VaibhavAher100/stm32-vitals-monitor/results/both_sensors_combined_output.png

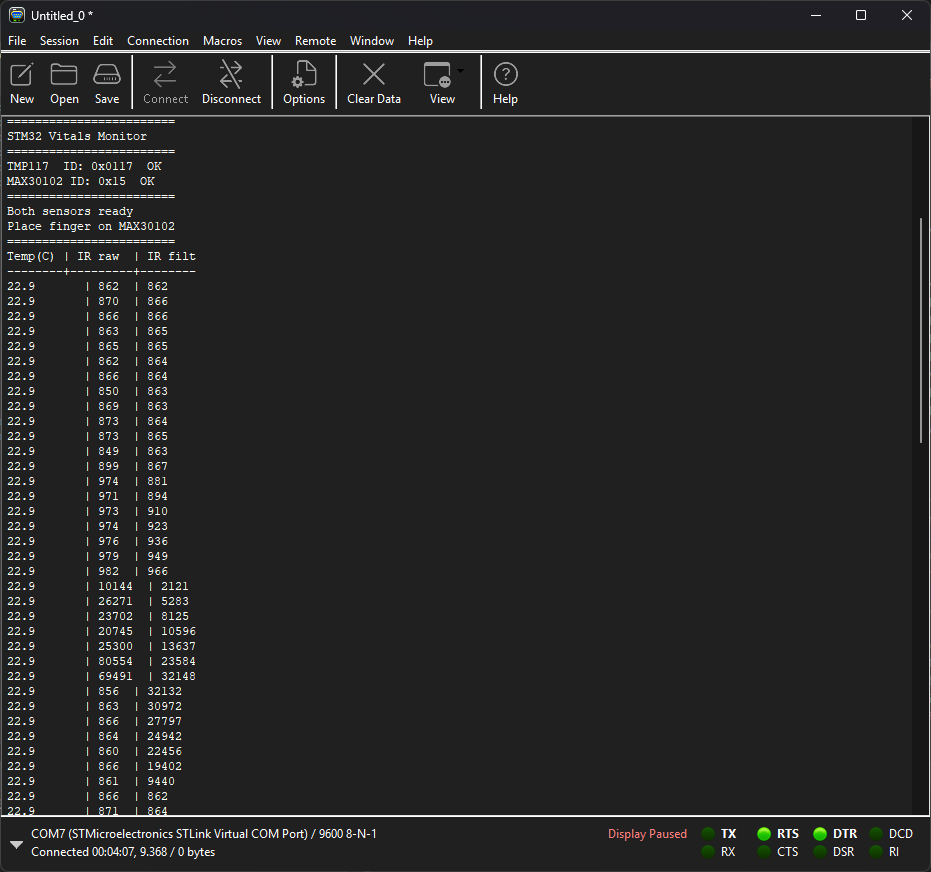
results/both_sensors_combined_output.png
