VaibhavAher100/stm32-vitals-monitor/results/freertos_bpm_output_verified.png

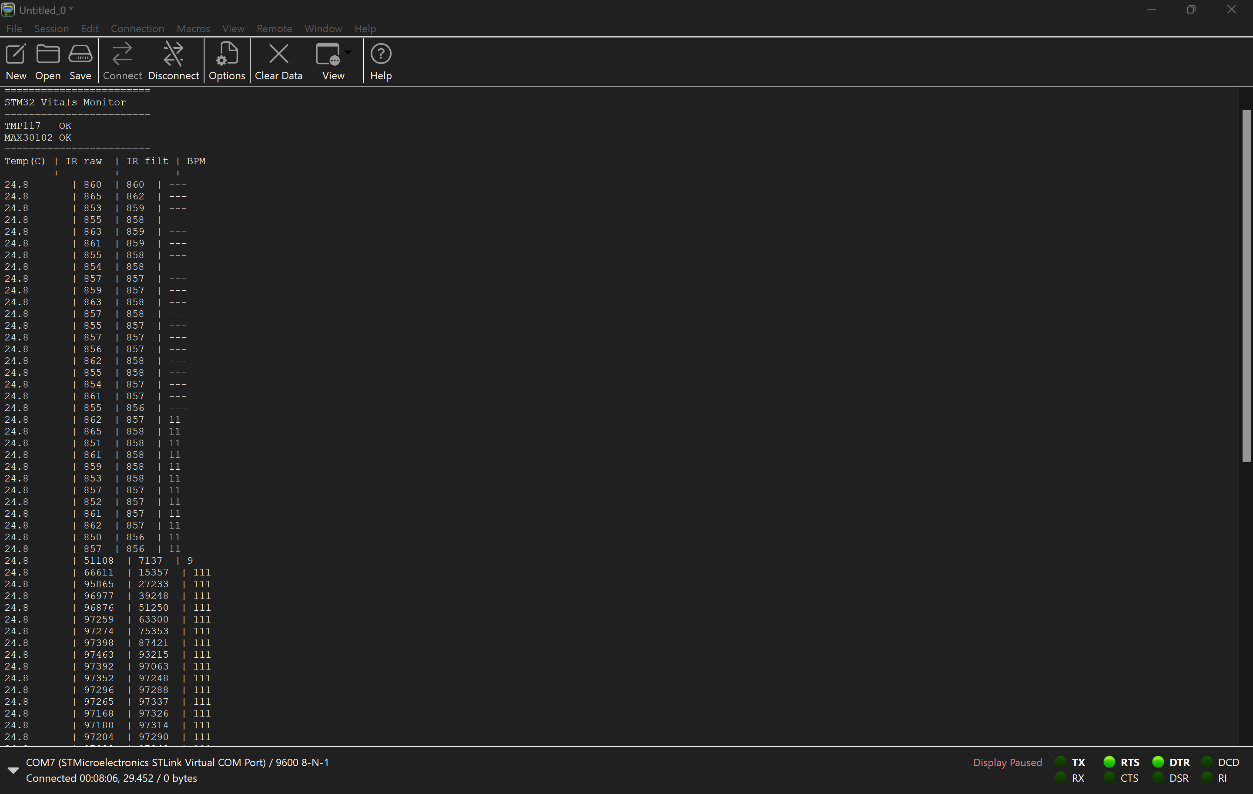
results/freertos_bpm_output_verified.png
