VaibhavAher100/stm32-vitals-monitor/results/i2c_scanner_both_sensors.png

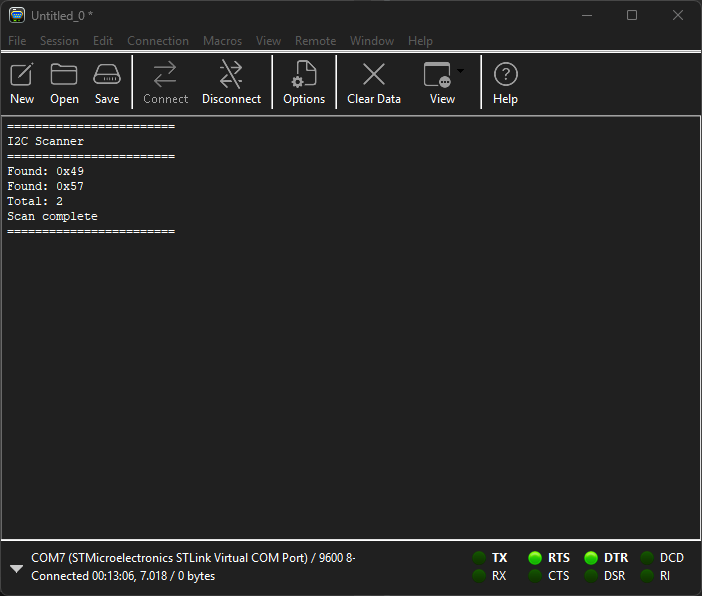
results/i2c_scanner_both_sensors.png
