VaibhavAher100/stm32-vitals-monitor/results/max30102_ir_raw_verified.png

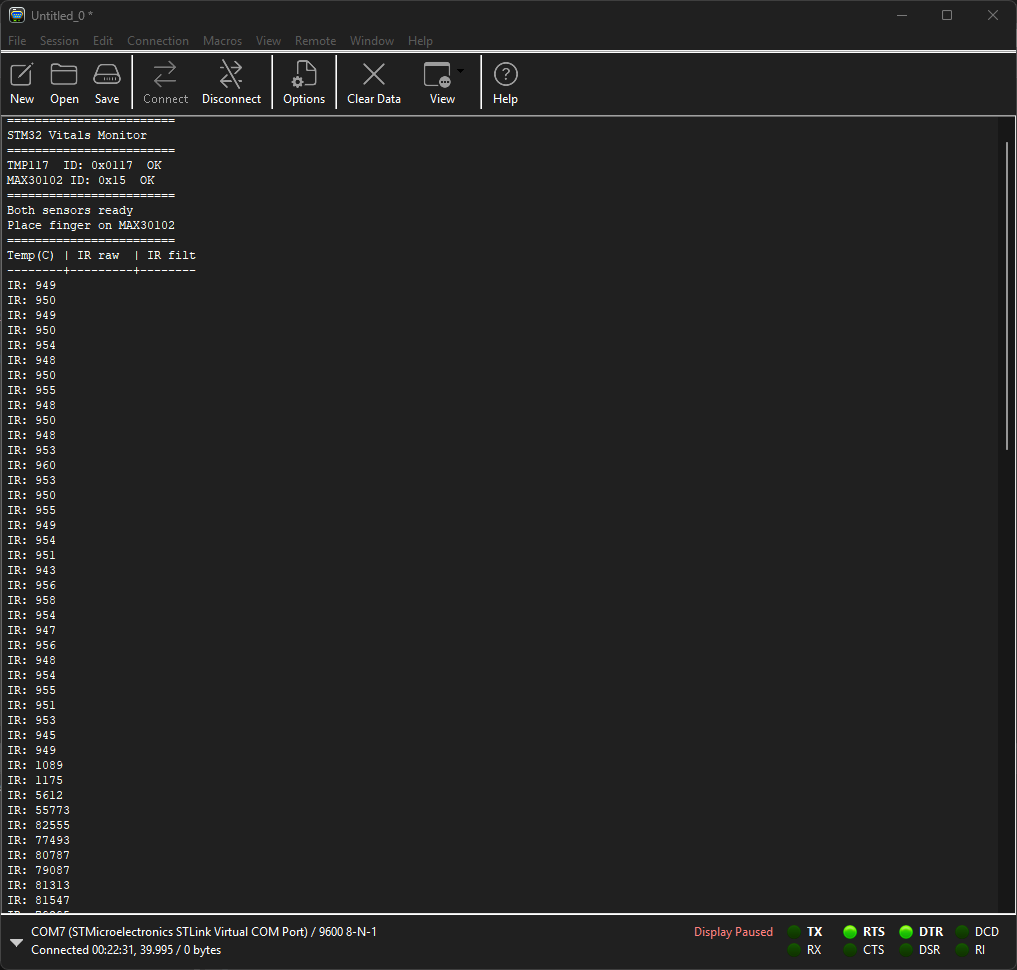
results/max30102_ir_raw_verified.png
