VaibhavAher100/stm32-vitals-monitor/(commit log)

2026-03-26 feat: UART verified - STM32 Vitals Monitor banner and loop counter printing clean on COM7 9600 baud
2026-03-26 docs: add architecture, registers, wiring, limitations and sensor datasheets
2026-03-26 docs: add architecture, registers, wiring, limitations, datasheets - remove stale placeholders
2026-03-26 chore: restore clean UART baseline after I2C debug session
2026-03-27 feat: TMP117 I2C driver working - device ID 0x0117, temperature reading 24.4C verified
2026-03-27 feat: both sensors working - TMP117 temp + MAX30102 IR with moving average filter, combined UART output verified
2026-03-28 feat: all sensors verified - UART, I2C scanner, TMP117 temp, MAX30102 IR, combined output with moving average filter
2026-03-28 docs: update portfolio page - all milestones current, combined sensor output in terminal
2026-03-28 refactor: split monolithic main.c into 3-layer architecture - driver, processing, application
2026-04-04 docs(phase-1): code quality documentation and MISRA fixes
    docs/requirements.md: 49 traceable requirements derived from source (IEC 62304 §5.2 style)
    docs/testing.md: 9 test cases with hardware evidence and static inspection; 49/49 coverage
    docs/misra.md: Cppcheck MISRA C:2012 analysis — 38 violations fixed, 98 justified deviations
    Code fixes (Rules 10.4, 15.6, 17.7, 17.8, 5.9, 8.7):
    - Added braces to all single-statement if/while bodies (Rule 15.6)
    - (void)-cast all discarded i2c_write_reg() return values (Rule 17.7)
    - Local copies for all modified function parameters (Rule 17.8)
    - Renamed static delay() to main_delay/i2c_delay/max30102_delay (Rule 5.9)
    - Removed dead uart_hex() from uar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
    [filter.c, i2c.c, main.c, max30102.c, uart.c]
2026-04-04 feat(phase-2): SysTick calibrated delay and IWDG watchdog
    - systick.c/h: SysTick_Handler increments volatile ms counter; delay_ms uses
    unsigned subtraction for rollover-safe wait; get_tick for future timeouts
    - iwdg.c/h: prescaler /32, reload 4000 → 4 s timeout at 32 kHz LSI; 8× margin
    - Removed spin-loop delays (main_delay, i2c_delay, max30102_delay); all 10 call
    sites replaced with delay_ms()
    - main.c: systick_init → iwdg_init → uart_init → i2c_init startup order;
    iwdg_kick() in main loop; for(;;) replaces while(1) (MISRA Rule 14.2)
    - docs: REQ-SYS-06, REQ-SYS-07 added; TC-10, TC-11 added; coverage 51/51
    [i2c.c, iwdg.c, main.c, max30102.c]
2026-04-04 feat(phase-3): BPM heart rate detection from PPG signal
    - bpm.h/c: dynamic-threshold rising-edge detector on filtered IR signal;
    rolling 8-sample min/max window; midpoint threshold; 333 ms refractory
    period (max 180 BPM); BPM = 60000 / interval_ms; returns BPM_INVALID
    until two valid crossings recorded
    - main.c: BpmDetector integrated; BPM column added to UART output; displays
    '---' while waiting for first valid beat pair
    - docs: REQ-SYS-08 added; TC-12 added; coverage updated to 52/52
2026-04-04 feat(phase-4): FreeRTOS task separation
    Vendor FreeRTOS V10.5.1 kernel source into firmware/Middlewares/FreeRTOS/.
    Split monolithic main loop into two tasks communicating via a depth-1 queue:
    - task_sensor (priority 2): reads TMP117 + MAX30102, filters, detects BPM,
    sends VitalsMsg to vitals_queue, kicks IWDG every 500 ms via vTaskDelay.
    - task_uart (priority 1): blocks on queue, formats and transmits UART row.
    FreeRTOS owns SysTick — systick.c/h removed; bpm.c uses xTaskGetTickCount();
    i2c.c / max30102.c use vTaskDelay() for post-scheduler delays; pre-scheduler
    init uses a local busy_delay_ms() loop. Sensor init moved into task_sensor so
    vTaskDelay() is safe to call during MAX30102 res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
2026-04-06 Phase 1 - code quality documentation and MISRA fixes
    docs/requirements.md: 49 traceable requirements derived from implemented
    firmware - system, UART, I2C, TMP117, MAX30102, filter, output, non-functional.
    docs/testing.md: 9 test cases, 6 hardware + 3 static inspection. All backed
    by existing results/ screenshots or reproducible grep commands. All PASS.
    docs/misra.md: Cppcheck 2.20.0 MISRA C:2012 analysis - 136 findings across
    12 rules. 38 fixed in source, 98 justified deviations documented with rationale.
    Note added that MISRA C:2025 is the current published standard.
    Firmware fixes:
    - (void)-cast all discarded i2c_write_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
    [filter.c, i2c.c, main.c, max30102.c, uart.c]
2026-04-06 feat: add SysTick calibrated delay and IWDG watchdog
    Replaces the spin-loop delay functions with a proper SysTick-based 1ms
    tick counter, and adds an independent watchdog to recover from hangs.
    systick.c/h:
    - SysTick configured at 1ms tick (4MHz / 1000Hz, reload = 3999)
    - delay_ms() uses unsigned subtraction for rollover-safe wait
    - get_tick() exposes the counter for future use
    iwdg.c/h:
    - LSI clock, prescaler /32, reload 4000 -> 4s timeout
    - 8x safety margin over the ~500ms main loop period
    - iwdg_kick() called at the top of the main loop
    All three spin-loop delay functions removed from main.c, i2c.c, max30102.c.
    docs/requirements.md and docs/testing.md updated to cover the new behaviour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
    [i2c.c, iwdg.c, main.c, max30102.c]
2026-04-07 feat(bpm): add BPM heart rate detection from PPG signal
    bpm.h/c: dynamic-threshold rising-edge detector on filtered IR signal;
    until two valid crossings recorded.
    main.c: BpmDetector integrated; BPM column added to UART output; displays
    '---' while waiting for first valid beat pair.
    docs: REQ-SYS-08 added; TC-12 added; limitations updated to reflect BPM
    implementation and SysTick availability.
    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
2026-04-07 feat(phase-4): FreeRTOS integration verified on hardware
    - fix(iwdg): enable LSI before config; write 0xCCCC before 0x5555 so
    PVU/RVU sync flags can clear - was hanging forever without this
    - fix(i2c): busy-wait in init (pre-scheduler), vTaskDelay in transactions
    - fix(freertosconfig): INCLUDE_xTaskGetCurrentTaskHandle 0 -> 1
    - feat(main): single FreeRTOS task wrapping Phase 3 sensor loop
    - chore: move project root from Core/ to firmware/ - Middlewares/ must
    be inside project scope for CubeIDE to compile FreeRTOS kernel
    - chore: add linker scripts and project files at firmware/ level
    - verified on hardware: TMP117 24.8C, MAX30102 IR streaming, BPM 111,
    IWDG kicking every 500ms - TC-13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
    [i2c.c, iwdg.c, main.c]
2026-04-07 chore: remove stale Core/ project files and dead code after project restructure
    - Core/.cproject, Core/.project, Core/.settings removed - project root
    moved to firmware/, these are orphaned artifacts
    - Core/STM32L476RGTX_FLASH.ld, Core/STM32L476RGTX_RAM.ld removed -
    linker scripts now live at firmware/ level
    - tasks_vitals.c, tasks_vitals.h removed - single-task design in main.c
    makes these dead code
2026-04-07 feat(phase-4): FreeRTOS integration verified on hardware
    Single FreeRTOS task wrapping the Phase 3 sensor loop. Two-task queue
    architecture was the original design but single-task was simpler and
    sufficient to demonstrate RTOS on this hardware.
    Fixes found during hardware testing:
    - iwdg: LSI must be enabled before IWDG config; 0xCCCC (start) must
    come before 0x5555 (unlock) - PVU/RVU sync flags never cleared
    otherwise, causing an infinite hang before main() printed anything
    - i2c: replaced systick delay_ms with busy-wait in init (pre-scheduler)
    and vTaskDelay in transaction functions (called from within task)
    - freertosconfig: INCLUDE_xTaskGetCurrentTaskHandle 0 -> 1
    - project root m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
    [bpm.c, i2c.c, iwdg.c, main.c, max30102.c]
2026-04-07 docs: fix em dashes and mark TC-13 PASS
    Replace all em dashes with hyphens across all docs and session log
    (architecture, limitations, misra, registers, requirements, testing,
    wiring). TC-13 updated with actual hardware results and procedure
    corrected to match single-task FreeRTOS implementation.
2026-04-07 feat(portfolio): Phase 4 verified output, index improvements, TC-13 evidence
    index.html:
    - add hero capability tags (scannable +tag format replacing dense paragraph)
    - add phase connector between Phase 1-3 and Phase 4 terminals showing what
    changed (BPM, FreeRTOS, IWDG, vTaskDelay)
    - add RTOS spec to hero spec row
    - add second warn-box for IWDG LSI bug (debugged with GDB)
    - add IWDG registers to register map (RCC_CSR, IWDG_KR, IWDG_PR, IWDG_RLR)
    - add Phase 1-4 section dividers to build log with CSS classes
    - fix broken em-dash replacement in register map note
    README.md:
    - update output block to 4-column format with BPM
    - update architecture block (add bpm.c, iwdg.c, FreeRTOS context)
    - u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
2026-04-09 sync: replace single-task main.c with two-task architecture from local
    [main.c, tasks_vitals.c, tasks_vitals.h]
2026-04-09 vendor: add CMSIS device and core headers from STMicroelectronics/cmsis-device-l4 and ARM-software/CMSIS_5
2026-04-09 refactor(drivers): CMSIS struct access, remove raw-address macros and in-function defines
2026-04-09 cleanup: strip MISRA rule annotations; replace auto-generated attribution in syscalls/sysmem
    [bpm.c, filter.c]
2026-04-09 hw verified: CMSIS build clean, BPM 119, TMP117 25.3C on Nucleo-L476RG
    - Track .cproject/.project: CMSIS include paths and FreeRTOS linked
    resources now in repo so clone builds without manual IDE config
    - Add linker scripts to firmware/Core/ (required by CubeIDE workspace path)
    - README: update hardware-verified numbers (25.3C, IR ~86000, BPM 119)
    and output section with actual terminal capture
    - docs/testing.md: rewrite TC-09 for CMSIS (no raw hex), update TC-13
    numbers, add TC-14 (CMSIS full build + hardware run), replace orphaned
    requirements matrix with 14-row test summary table
2026-04-09 site: align with two-task architecture, CMSIS, and verified hardware numbers
    - Fix architecture section: single task_vitals → task_sensor + task_uart
    + depth-1 queue (xQueueOverwrite/xQueueReceive); files list updated
    - Fix Phase 4 build log: matches actual two-task design and real numbers
    (25.3C, IR ~86000, BPM 119)
    - Hero: precise "No CubeMX" wording — peripheral init is handwritten using
    CMSIS device headers; syscalls.c/sysmem.c classified as IDE-generated stubs
    - Register map: replace all raw hex addresses with CMSIS access notation
    (USART2->BRR, RCC->CSR, etc.) — no addresses to mistype or verify manually
    - Bug #1 warn box: reframe as CMSIS-resolved (compiler handles offse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
2026-04-09 docs: restructure README and update index.html to match hardware verification
    README: 4-fact header, inline verification table, correct ambient IR (~775),
    two-task architecture description, actual terminal output from hardware run.
    index.html: correct IR values (87000), two-task architecture throughout,
    real terminal data (25.3 C, filter ramp, BPM 119), CMSIS register map,
    authored vs IDE-generated stubs labelled.
2026-05-14 refactor(max30102): route 3-byte FIFO read through i2c driver
    read_fifo_3bytes() was accessing I2C1 registers directly, bypassing
    the i2c abstraction layer. Adds i2c_read_3bytes() to i2c.c following
    the same pattern as i2c_read_2bytes(). max30102.c now calls
    i2c_read_3bytes() and applies the 18-bit mask locally.
    Removes stm32l476xx.h and FreeRTOS includes from max30102.c; neither
    is needed after the refactor.
2026-05-15 docs: restore and update requirements/misra, add traceability, fix AI slop
    - Restore docs/requirements.md (deleted in c1d2227): updated to v2.0
    with RTOS, IWDG, BPM, SysTick, timing requirements; REQ-NF-04
    updated for CMSIS struct access; [FUTURE] items now done removed
    - Restore docs/misra.md (deleted in c1d2227): pre-CMSIS analysis note
    added, Rule 11.4 marked obsolete, CMSIS re-run command added
    - docs/architecture.md: remove lecture-style sentences, update for
    FreeRTOS/CMSIS/bpm.c, fix file structure and design decisions
    - docs/limitations.md: remove philosophical opener, remove Out of Scope table
    - README.md: remove inline output annotations
    - firmware/Core/Src/*.c: add IEC 6230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
    [bpm.c, filter.c, i2c.c, iwdg.c, main.c, max30102.c, tasks_vitals.c, tmp117.c]
2026-05-15 test: add Unity host-side unit tests for filter.c and bpm.c
    tests/test_filter.c: 8 test cases covering REQ-FIL-01 to REQ-FIL-06
    - init zeros all fields, single value, partial fill, full window average,
    rollover drops oldest, identical values, count saturation, re-init
    tests/test_bpm.c: 7 test cases covering REQ-BPM-01 to REQ-BPM-05
    - invalid before crossings, no crossing during fill, invalid after one
    crossing, valid BPM at 600ms/100BPM, refractory rejection, 500ms/120BPM,
    flat signal never crosses
    tests/stubs/: minimal FreeRTOS.h + task.h stubs, stub_freertos.c with
    controllable xTaskGetTickCount() for deterministic BPM interval tests
    All 15 tests pass on host (gcc -Wall -Wextra -W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
2026-05-15 chore: EXT-01/EXT-02 - cppcheck clean, verify script, bpm.c scope fix
    - verify.sh: arm-none-eabi-gcc -Wall -Wextra -Werror syntax check on all
    9 project source files; run with CROSS_GCC=/path/to/gcc ./verify.sh
    All 9 files PASS under -Wall -Wextra -Werror (gcc 14.3.1)
    - bpm.c: move now/elapsed declarations into their enclosing blocks to
    reduce scope - flagged by cppcheck variableScope, correct practice
    - docs/misra.md: update with re-run results on full CMSIS codebase;
    zero cppcheck findings in project source; Rule 11.4 confirmed obsolete
    [bpm.c]
2026-05-15 fix: doc corrections from expert review and synthesis audit
    - limitations.md: trim opener to 'Known limitations'
    - misra.md: add current-codebase status to each deviation section
    (Rules 12.2, 13.3, 13.5, 14.4, 15.5 still present; Rule 11.4 obsolete)
    - testing.md: TC-09 label clarified to 'no hardcoded peripheral base
    addresses'; note added explaining bitmasks and keys are not addresses
    - tmp117.c: fix comment (divide by 10000 -> divide by 1000)
    - README: add development timeline paragraph
    [tmp117.c]
2026-05-16 fix: resolve 10 bugs found in multi-agent firmware review
    Critical:
    - i2c.c: fix all timeout loops — post-decrement wrap made every
    error-check path (if (!timeout)) dead code; now uses
    while(...&&(timeout>0U)){timeout--;} with if(timeout==0U) guards
    - i2c.c: add BUSY-wait timeout guard before every CR2 write; previously
    a stuck bus caused the driver to start a new transaction anyway
    - max30102.c: replace busy_delay_ms(150U) with vTaskDelay(150ms) —
    init runs inside task_sensor post-scheduler, not pre-scheduler as
    the stale comment claimed; 150ms CPU spin blocked the scheduler
    High:
    - max30102.c: add REG_FIFO_OVF (0x05) clear to FIFO flush sequence;
    datasheet §6.3 requires a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
    [bpm.c, bpm.h, i2c.c, main.c, max30102.c, tasks_vitals.c, tmp117.c]
2026-05-16 feat(index): redesign landing page — light theme, bug archaeology, full responsive
    Switch from dark phosphor-green to light-primary OKLCH palette (warm
    paper, dark terminal insets). Inter Tight replaces Fraunces; all
    impeccable absolute bans eliminated (no side-stripe borders, no hex in
    CSS vars, no #000/#fff, no SaaS hero-metric template).
    New §02 Bug Archaeology section surfaces the seven firmware bugs that
    were previously buried in two warn-cards: IWDG write order, BRR offset
    typo, timeout post-decrement underflow, scheduler-blocking busy-wait,
    TMP117 formula, negative-temp sign, and BPM refractory tick math. Each
    entry has symptom / root cause / found-with / insight fields.
    Other ad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
2026-05-16 fix(index): prevent hero content from being clipped by fixed nav
    padding-top: max(96px, 10vh) on .hero-content so the eyebrow and h1
    always clear the fixed nav regardless of viewport height. Without this,
    short viewports (13.5-inch laptop at 768px tall, mobile) caused the
    content to stack from y=0, hiding behind the nav.
    Mobile: explicit 110px top padding clears the two-line wrapped nav.
    Tablet: max(88px, 10vh) via the 769-1024px breakpoint override.
    h1 clamp minimum reduced 52px->40px desktop, 36px mobile so three
    lines fit without overflowing on narrow/short screens.
    verify-strip line-height 2.2->1.8 on mobile saves ~33px vertical space.
    hero-desc margin-bottom 40px->24px on mobile for sa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
2026-05-16 fix(firmware): resolve 13 bugs from multi-agent audit
    - linker: _Min_Heap_Size 0x200 -> 0x2000 (both .ld files)
    - FreeRTOSConfig: heap 4096->16384, min stack 128->256
    - i2c: atomic CR2 writes per RM0351 s37.4.5
    - i2c: NACK/BERR/ARLO error detection on all waits
    - max30102: check every i2c_write_reg return in init
    - uart: guard INT32_MIN before negation (signed overflow UB)
    - uart: define __io_putchar() for newlib printf support
    - bpm: rename last_cross_ms/interval_ms -> *_ticks
    - bpm: BPM_MIN/BPM_MAX constants replace magic 30/200
    - filter: rounded moving average (sum + count/2) / count
    - tmp117: return INT32_MIN sentinel on double-zero read
    - tasks_vitals: emit UART message in stack overflo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
    [bpm.c, bpm.h, filter.c, i2c.c, max30102.c, tasks_vitals.c, tmp117.c, uart.c]
2026-05-16 fix(bpm): correct DC estimator, Schmitt trigger, timing - hardware verified May 2026
    Root causes found through hardware testing:
    - DC_SHIFT 3 (320ms) tracked heartbeat, suppressing AC - corrected to 6 (2560ms)
    - PPG_HYSTERESIS 25 dead zone wider than signal swing - corrected to 8
    - Refractory 333ms allowed dicrotic notch double-detection - corrected to 600ms
    - FIFO batch timestamps quantised to 500ms - fixed with per-sample tick offsets
    Also: LED 3.2mA to 12.6mA, -Wall -Wextra -Werror in IDE, MISRA re-run clean,
    TC-12 updated with real hardware evidence (64-97 BPM at rest).
    [bpm.c, bpm.h, filter.h, i2c.c, main.c, max30102.c, max30102.h, tasks_vitals.c]
2026-05-16 fix: linker heap, READONLY keyword, wiring docs, PPG wrap, TMP117 sentinel
    - Heap 0x200→0x2000 in active Core linker script
    - Remove READONLY from both flash LD files (GCC10 incompatible)
    - README CN5 SCL/SDA pins corrected to pin 1/2
    - AC centering: signed delta prevents uint32_t underflow on DC drop
    - TMP117 INT32_MIN sentinel prints '---' instead of overflow garbage
    [tasks_vitals.c]
2026-05-17 docs: correct stale values across showcase and documentation
    - index.html: 74→79 commits, April→May 2026 verified date, BPM 119→64-97,
    IR ~87k→~196k, 8-sample→4-sample filter, 333ms→600ms refractory
    - docs/requirements.md: REQ-MAX-07 LED 0x10/3.2mA→0x3F/12.6mA,
    REQ-BPM-04 refractory 333ms→600ms
    - docs/testing.md: TC-13 actual result labelled as April 2026 Phase 4
    initial run; note added pointing to TC-12 for May 2026 re-run values
    - docs/misra.md: remove stale "pending" re-run command block (run done);
    Rule 11.4 remaining 26→0, disposition updated to obsolete
    - docs/limitations.md: replace false "not redistributed" claim with
    accurate list of the five tracked data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
2026-05-17 docs(index): fix bug-07 fix text and commit count
    Bug-07 card: pdMS_TO_TICKS(333) was the conversion fix; note that
    BPM_REFRACTORY_MS was later raised to 600 ms (current firmware).
    Commit count: 79→81 (self-referential, accounts for this commit).
2026-05-17 feat(systemview): add SEGGER SystemView + RTT integration
    Patch FreeRTOS V10.5.1 kernel, add RTT/SYSVIEW sources, configure for
    STM32L476RG. Build verified. Live recording pending J-Link setup.
